srinathravichandran/Major-Project/Final Report/report images/Screenshot 2024-05-06 124802.png

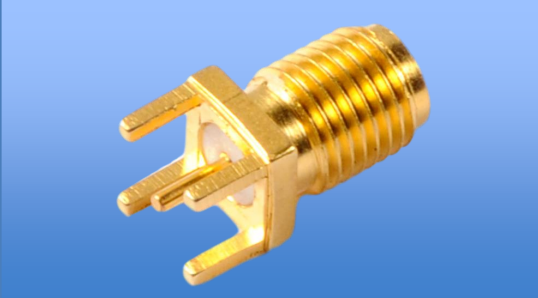
Final Report/report images/Screenshot 2024-05-06 124802.png
