srinathravichandran/Major-Project/Final Report/Radiation Pattern.png

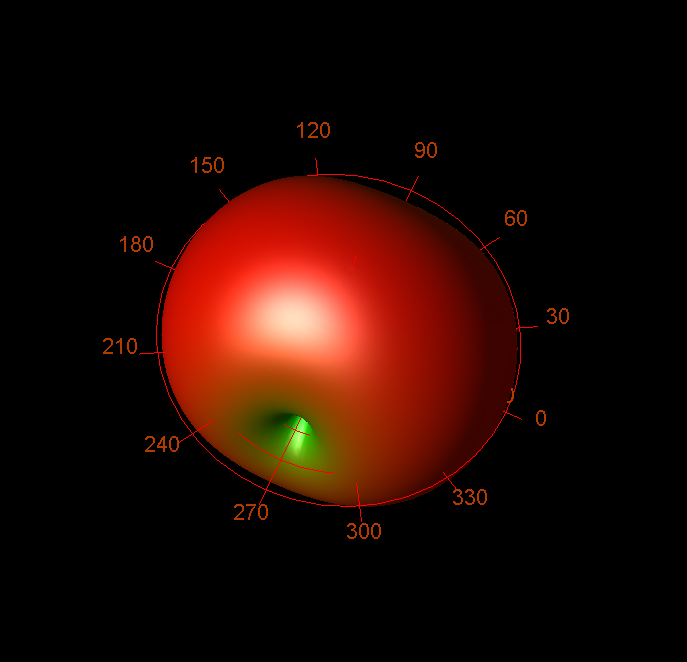
Final Report/Radiation Pattern.png
