srinathravichandran/Major-Project/Synopsis/Synopsis_124004308.docx

SYNOPSIS

Project Group No: 1

Register No: Name:

1. 124004308 Srinath.R

2. 124004361 Vijayarghavan.K.B

Project Title: Implementation of SDR-based Receiver using STM32 and nRF24L01

Name of the Guide: James A. Baskaradas / Associate Professor

Abstract

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

Specific Contribution

- On Omnidirectional Patch Antenna Designing, Fabricating & Testing it for a specific frequency of 2.4GHz
- On Interfacing the STM32 & nRF24L01 by employing embedded C on receiver side

Specific Learning

- Antenna Designing, Fabrication & Testing
- Embedded C

Technical Limitations & Ethical Challenges Faced

- Coding SPI Interface for nRF24L01
- Antenna Testing

Keywords: SPI Interface, nRF24L01, Patch Antenna, STM32, Dongle, Embedded C, Fabrication

Signature of the Student Signature of Guide

Date: 15th April 2024 1
