srinathravichandran/Major-Project/balun.png

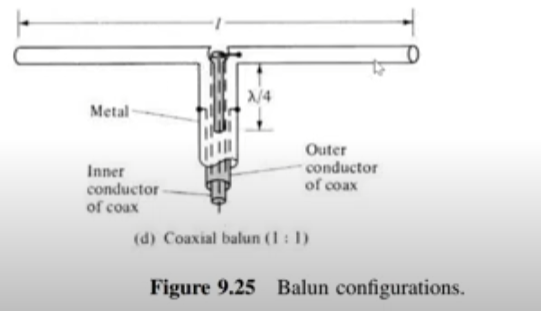
balun.png
