srinathravichandran/Major-Project/Final Report/Additional Graphs.png

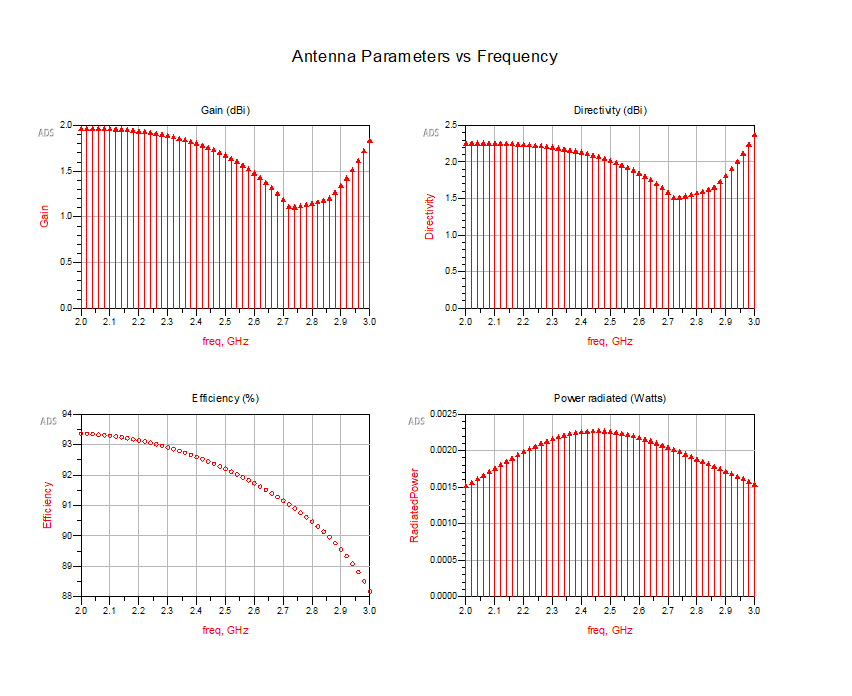
Final Report/Additional Graphs.png
