srinathravichandran/Major-Project/Final Report/Antenna Parameters.png

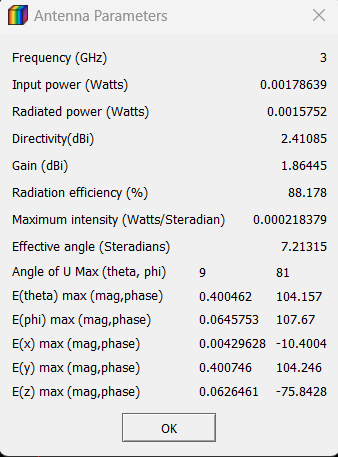
Final Report/Antenna Parameters.png
