srinathravichandran/Major-Project/Final Report/NEW/Patch_Antenna.png

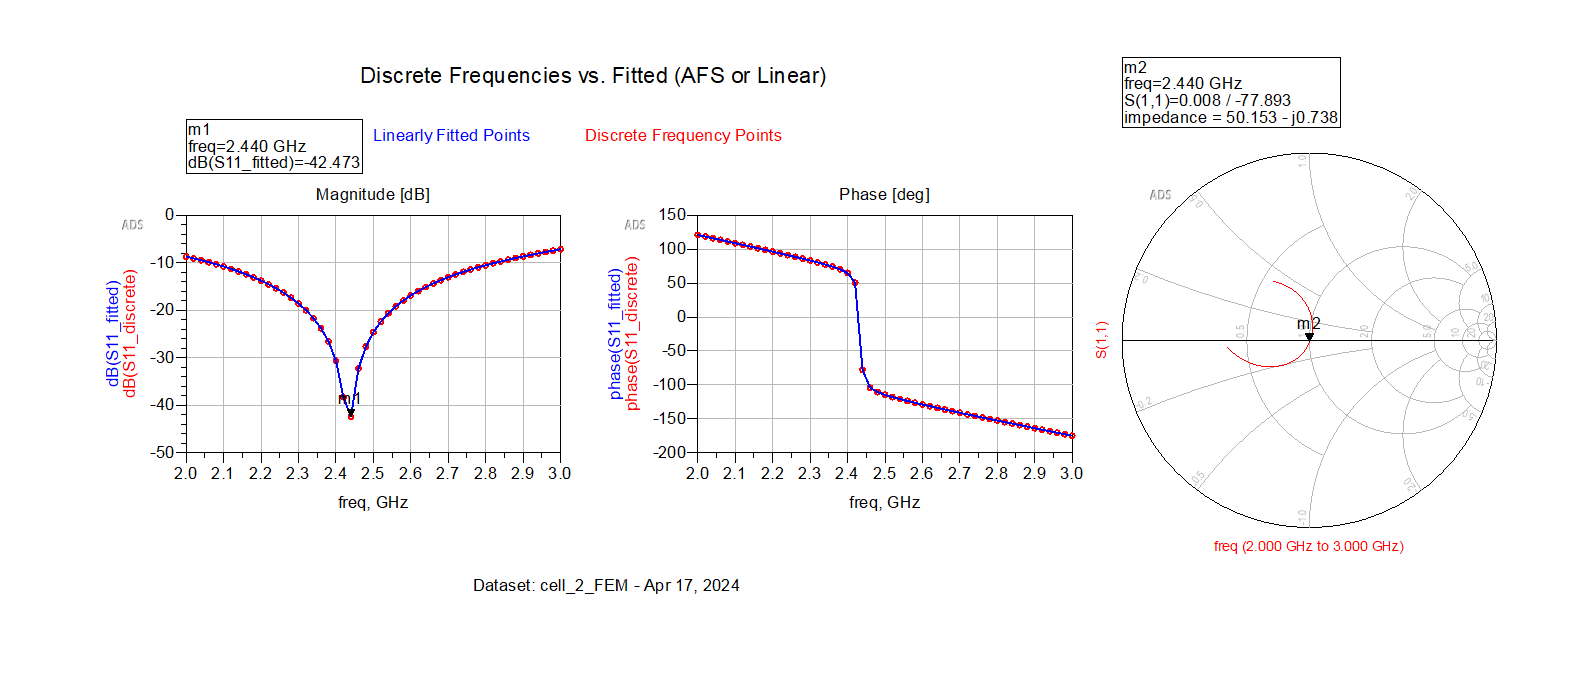
Final Report/NEW/Patch_Antenna.png
