srinathravichandran/Major-Project/Final Report/Patch Antenna.png

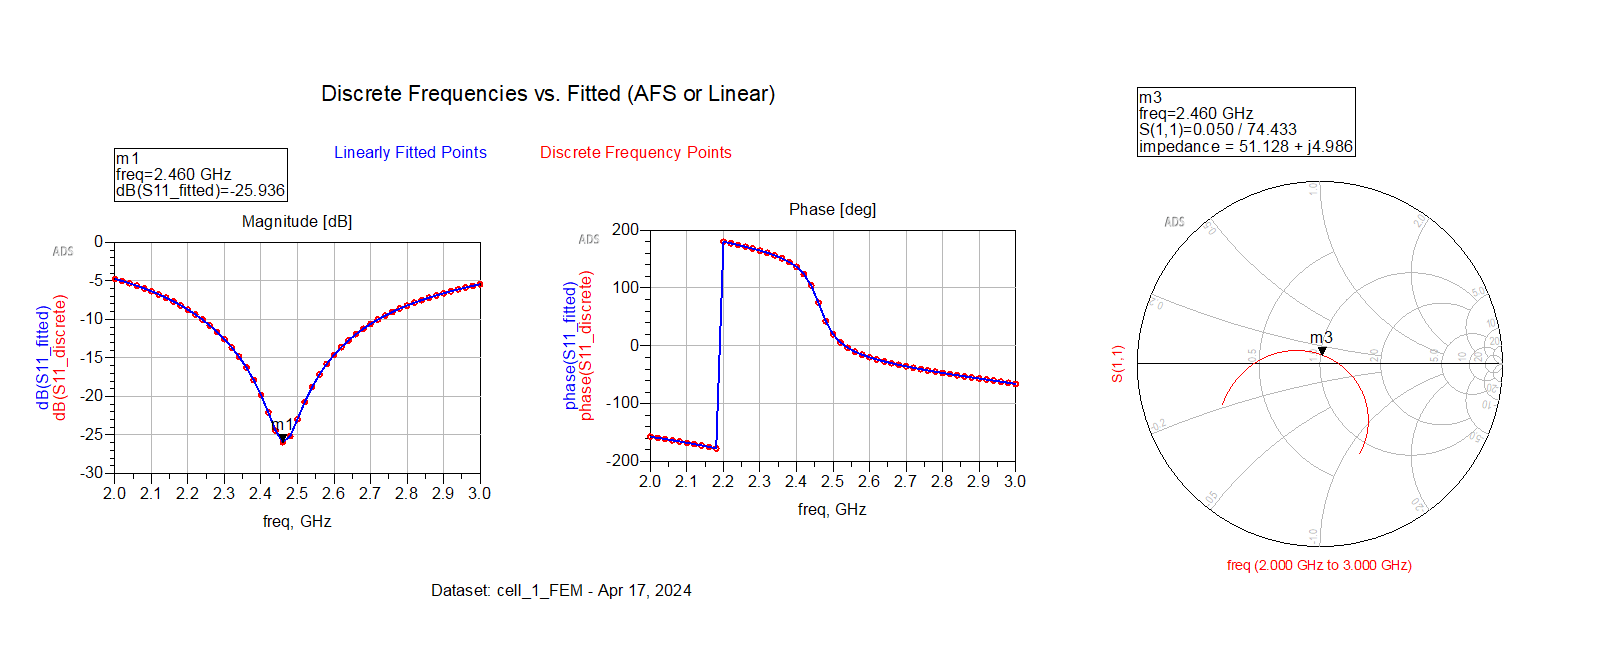
Final Report/Patch Antenna.png
