srinathravichandran/Major-Project/Final Report/report images/hardware and sdr.png

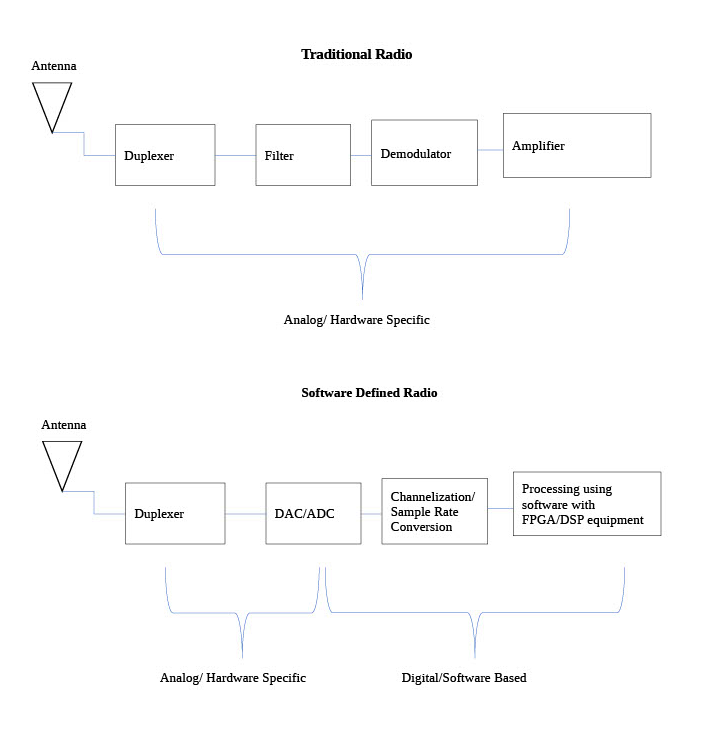
Final Report/report images/hardware and sdr.png
