srinathravichandran/Major-Project/frequency of C.D.A with Balun.png

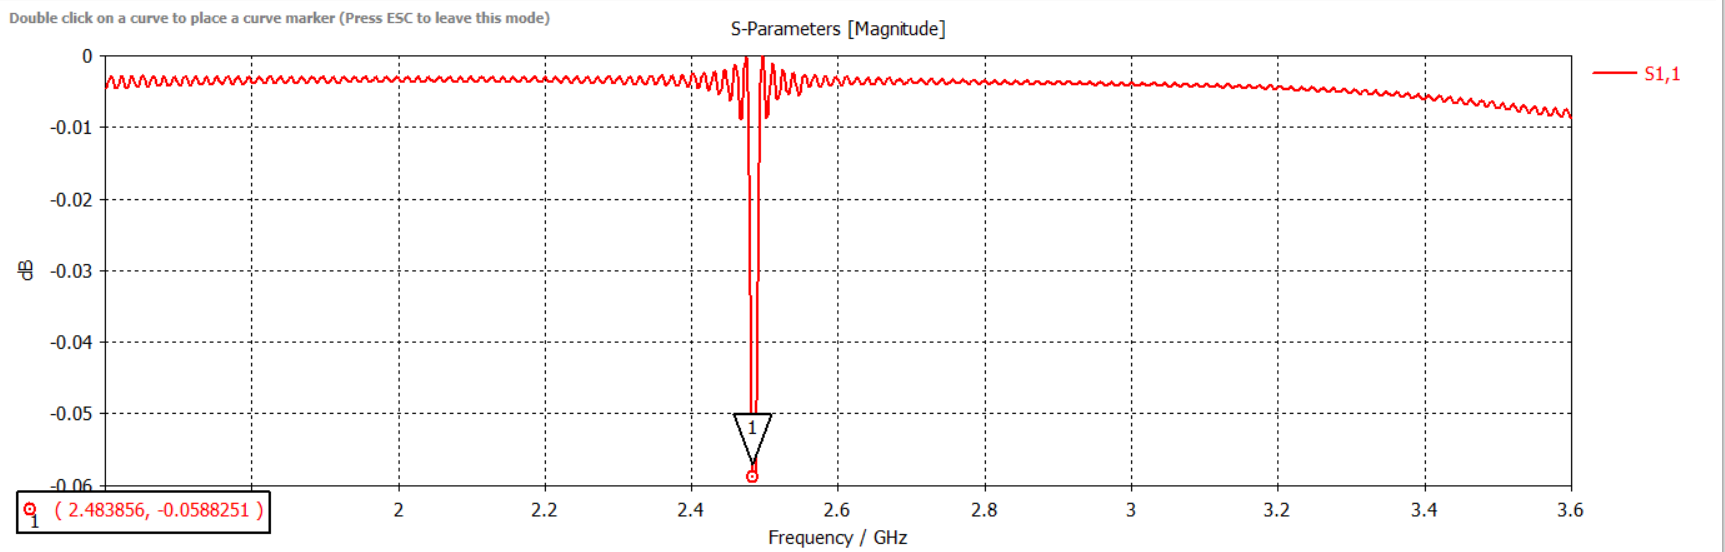
frequency of C.D.A with Balun.png
