srinathravichandran/Major-Project/patch antenna in ads.png

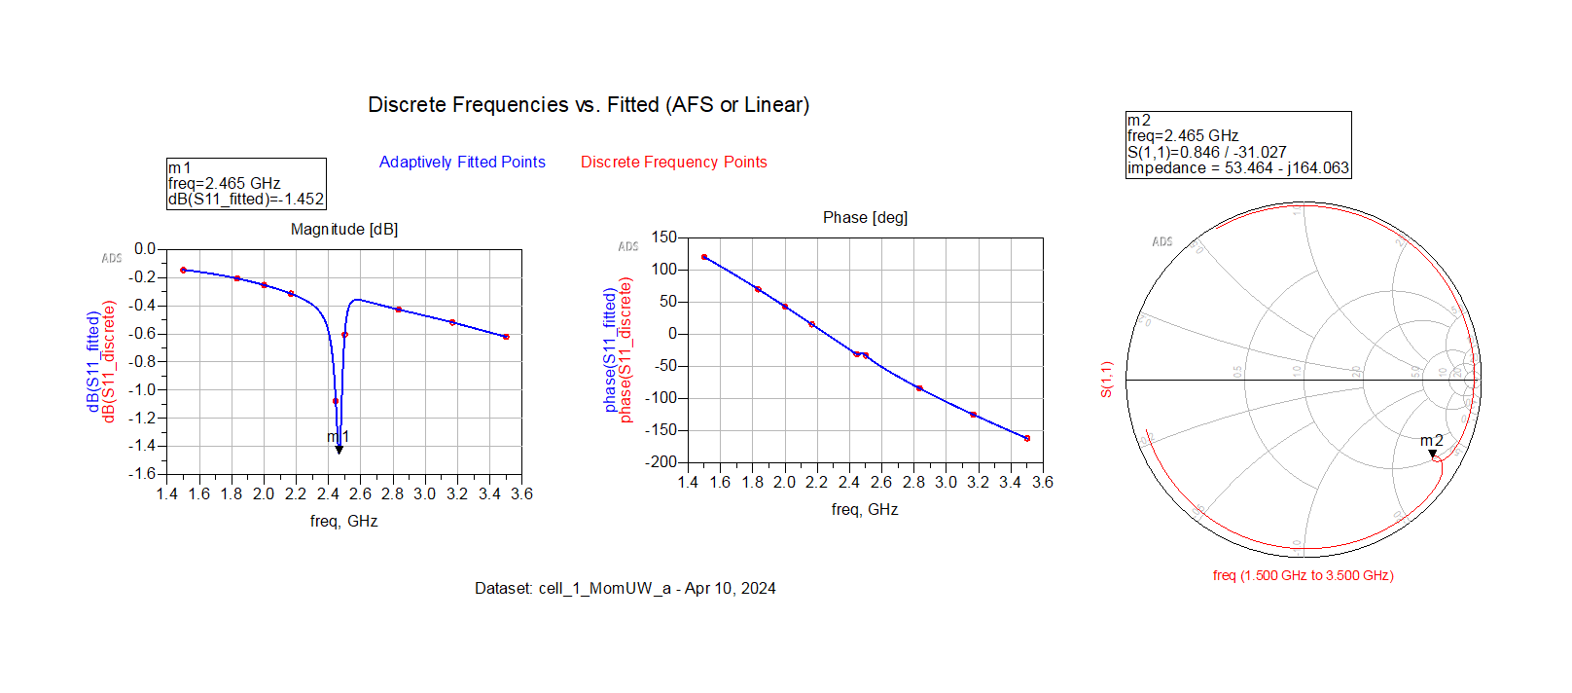
patch antenna in ads.png
