srinathravichandran/Major-Project/Screenshot 2024-04-25 120509.png

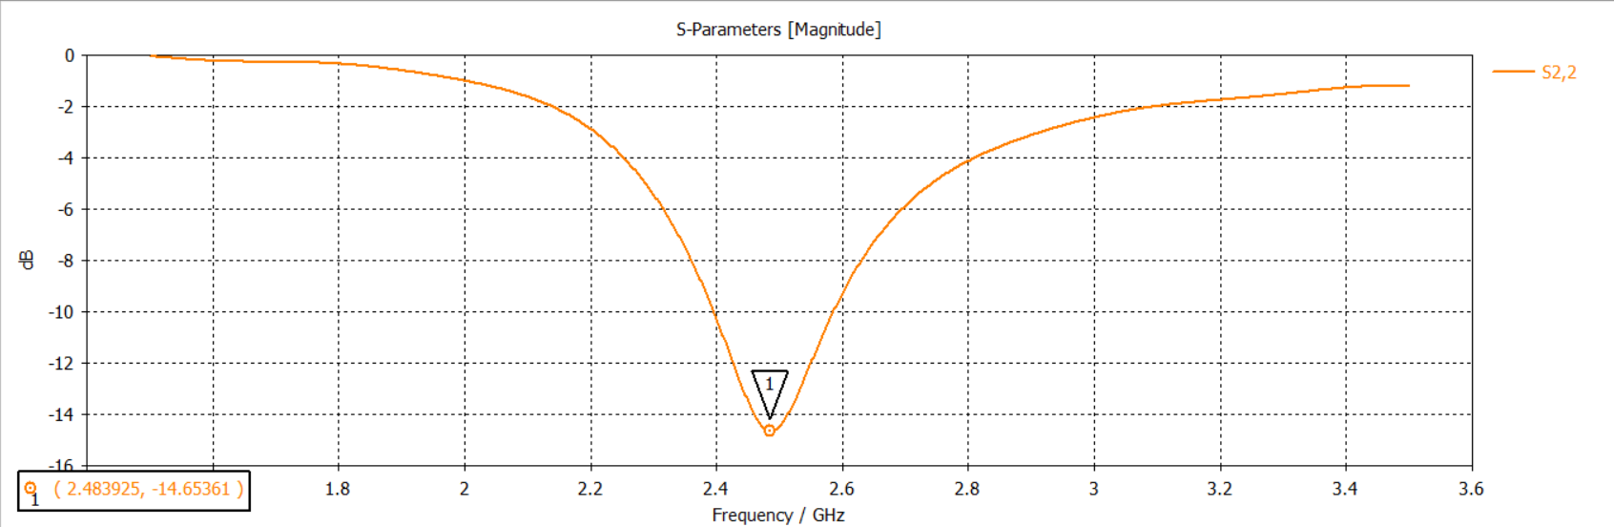
Screenshot 2024-04-25 120509.png
