srinathravichandran/Major-Project/Screenshot 2024-04-25 120854.png

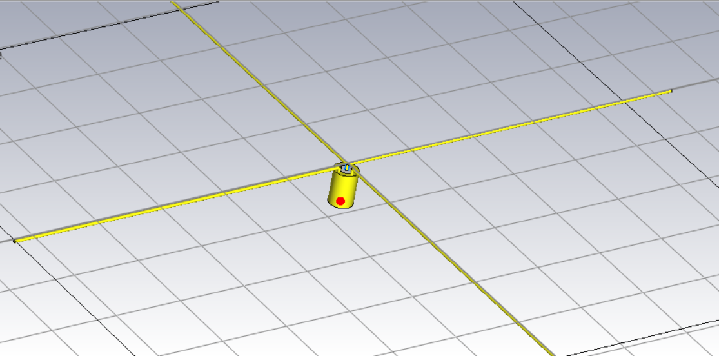
Screenshot 2024-04-25 120854.png
