srinathravichandran/Major-Project/Screenshot 2024-04-25 151421.png

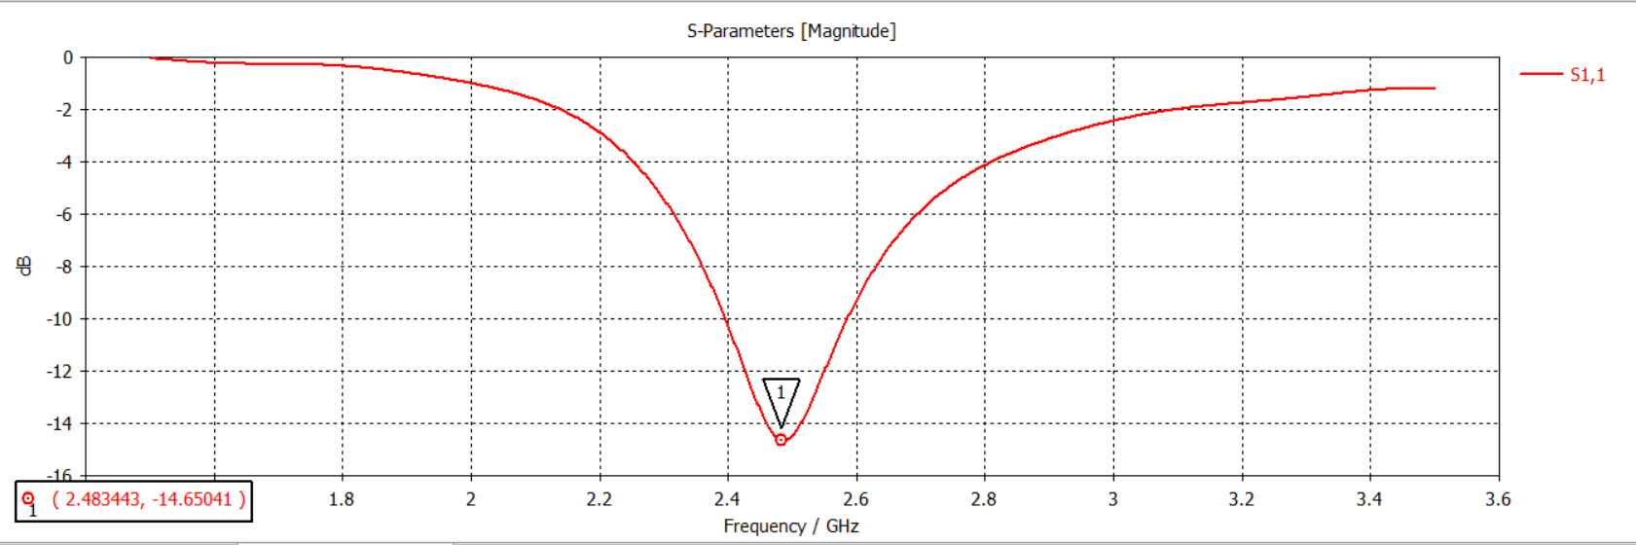
Screenshot 2024-04-25 151421.png
