srinathravichandran/Major-Project/trash/AD9854/AD9854_pin_diagram.jpg

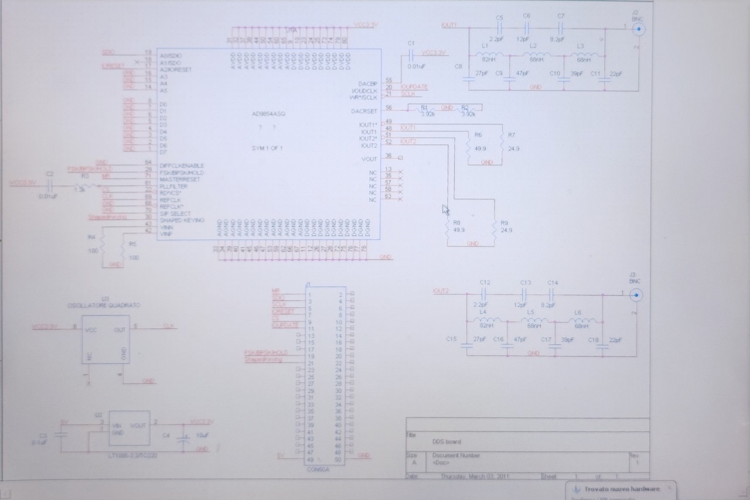
trash/AD9854/AD9854_pin_diagram.jpg
