srinathravichandran/Major-Project/trash/nRF to FPGA.png

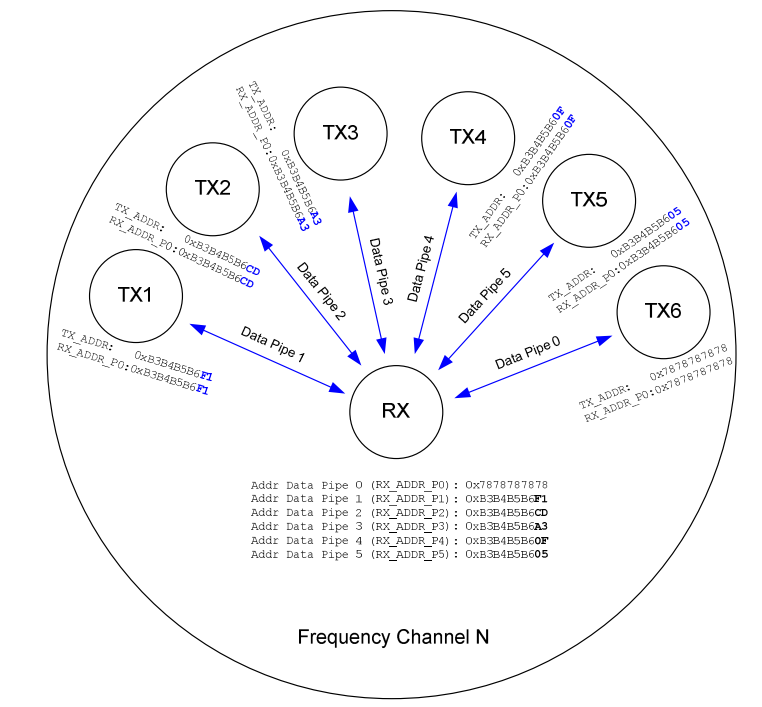
trash/nRF to FPGA.png
