srinathravichandran/Major-Project/trash/SPI.png

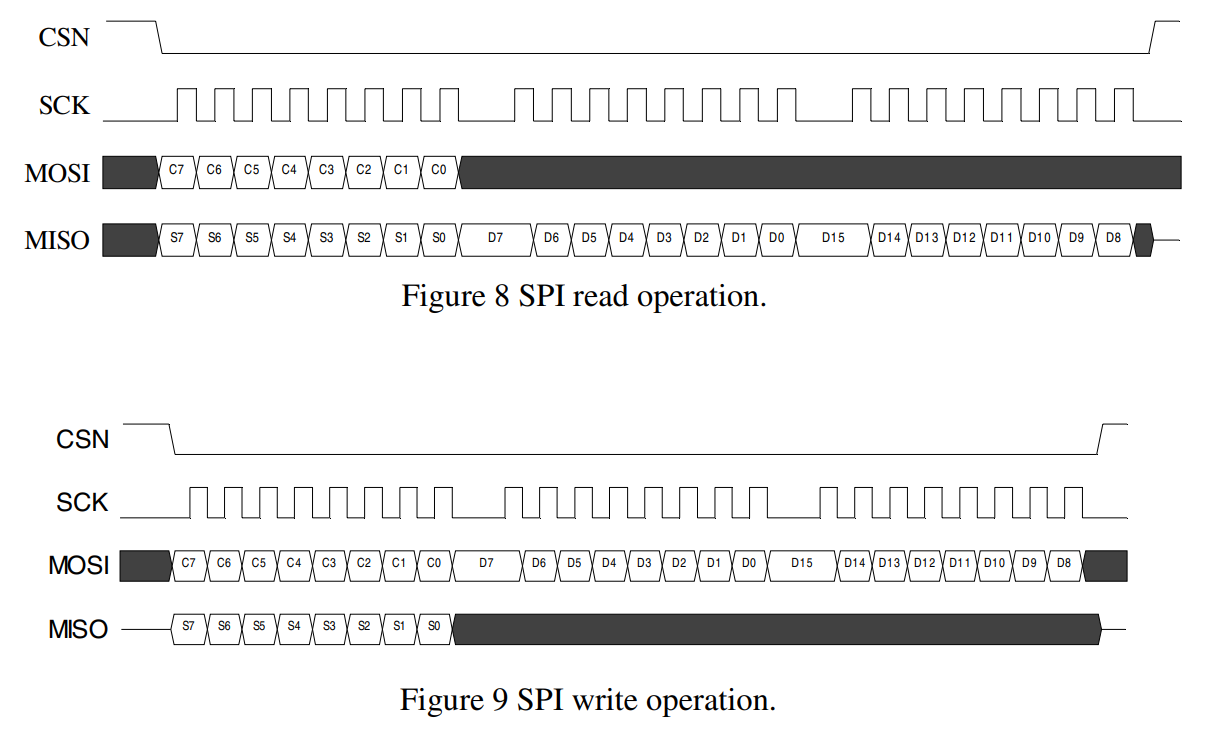
trash/SPI.png
