srinathravichandran/Major-Project/Trash/A_Horizontally_Polarized_Omnidirectional_Printed_Antenna_for_WLAN_Applications.pdf

IEEE TRANSACTIONS ON ANTENNAS AND PROPAGATION, VOL. 54, NO. 11, NOVEMBER 2006 | 3551

where the center pin is in contact with the hot electrode of the CPW
line and the four grounding pins are soldered to the ground-planes of this transmission line. The purpose of the small square slot at the center of the antenna (see Fig. 1 or Fig. 2) is help provide isolation between the hot electrode of the CPW transmission line and the surrounding ground-plane. In our original concept for the developed radiator, we were going to attempt to ‘edge’ feed the antenna from the center, however subsequently we were unable to source an interface small enough to accommodate the space required for the transition.

III. RESULTS

The predicted and measured return loss performance of the proposed small, uni-planar antenna is shown in Fig. 3. As can be seen from this plot, very good agreement between theory and experiment was achieved. The measured 10 dB return loss bandwidth for the radiator is 25 MHz compared to a predicted bandwidth of 35 MHz, however the minimum return loss for the measured case is better by almost 2 dB. The reasonable bandwidth, in excess of 5.5%, is due to the bandwidth of the slot primary radiating element, which inherently has more bandwidth than a patch antenna. The predicted and measured principal plane radiation patterns [XZ plane, =0 and YZ plane, = 90 where is defined in Fig. 1 and is the angle from the Z axis (out of the paper)] are shown in Fig. 4. Co-polar patterns are defined as radiation patterns with the linear polarization source antenna (a Yagi–Uda antenna) in the appropriate orientation and cross-polar patterns are taken with the source and antenna under test in orthogonal planes. The measurements were carried out at an outdoor antenna range. As can be seen from these results the patterns are in reasonable agreement, with higher cross-polarization levels, particularly towards endfire ( = 90), and scalping of the co-polar patterns in the measured patterns compared to the predicted results. These are characteristics that are typically observed for small antennas with truncated ground-planes. The measured gain was approximately 0 dBi, with an uncertainty of 2 dB. All cables used to make the measurement were covered with RF absorber to minimize their impact on the measured radiation patterns. The calculated efficiency of the antenna was approximately 75%.

IV. CONCLUSION

In this paper we have presented a new small, uni-planar printed antenna that has near omnidirectional radiation patterns. The antenna can be classified as a uni-planar version of a shorted spiral-like patch antenna, where in this case the primary radiator is a printed slot. The antenna is useful for wireless applications requiring thin, small radiators. Good agreement between the predicted and measured performance of the antenna has been achieved.

REFERENCES

[1] L. C. Godara, Handbook of Antennas in Wireless Communications. New York: CRC Press, 2002.
[2] W.-C. Liu, “Broadband dual-frequency meandered CPW-fed monopole antenna,” Electron. Lett., vol. 40, pp. 1319–1320, Oct. 2004.
[3] J.-Y. Chiou, J.-Y. Sze, and K.-L. Wong, “A broadband CPW-fed striploaded square slot antenna,” IEEE Trans. Antennas Propag., vol. 51, pp. 719–721, Apr. 2003.
[4] H. K. Kan and R. B. Waterhouse, “Small square dual-spiral printed antennas,” Electron. Lett., vol. 37, pp. 478–479, Apr. 2001.
[5] R. B. Waterhouse, “Small microstrip patch antenna,” Electron. Lett., vol. 31, pp. 604–605, Apr. 1995.
[6] N. K. Das and D. M. Pozar, “A generalized spectral domain Green’s function for multilayered dielectric substrates with applications to multilayered transmission lines,” IEEE Trans. Microw. Theory. Tech., vol. 35, pp. 326–335, Mar. 1987.

A Horizontally Polarized Omnidirectional Printed Antenna for WLAN Applications

C.-C. Lin, L.-C. Kuo, and H.-R. Chuang

Abstract—The design simulation, fabrication, and measurement of a 2.4-GHz horizontally polarized omnidirectional planar printed antenna for WLAN applications is presented. The antenna adopts the printed Alford-loop-type structure. The three-dimensional (3-D) EM simulator HFSS is used for design simulation. The designed antenna is fabricated on an FR-4 printed-circuit-board substrate. The measured input standing-wave-ratio (SWR) is less than three from 2.40 to 2.483 GHz. As desired, the horizontal-polarization H-plane pattern is quite omnidirectional and the E-plane pattern is also very close to that of an ideal dipole antenna. Also a comparison with the popular printed inverted-F antenna (PIFA) has been conducted, the measured H-plane pattern of the Alford-loop-structure antenna is better than that of the PIFA when the omnidirectional pattern is desired. Further more, the study of the antenna printed on a simulated PCMCIA card and that inserted inside a laptop PC are also conducted. The HFSS model of a laptop PC housing, consisting of the display, the screen, and the metallic box with the keyboard, is constructed. The effect of the laptop PC housing with different angle between the display and keyboard on the antenna is also investigated. It is found that there is about 15 dB attenuation of the gain pattern (horizontal-polarization field) in the opposite direction of the PCMCIA slot on the laptop PC. Hence, the effect of the large ground plane of the PCMCIA card and the attenuation effect of the laptop PC housing should be taken into consideration for the antenna design for WLAN applications. For the proposed antenna, in addition to be used alone for a horizontally polarized antenna, it can be also a part of a diversity antenna.

Index Terms—Alford loop, HFSS, horizontal polarization, laptop PC, omnidirectional, printed antenna, printed inverted-F antenna (PIFA), WLAN.

I. INTRODUCTION

Recently, with the rapid progress in the wireless communication technology, the demands of using the laptop and other portable computers with wireless modems as the terminals increase vastly in the wireless local area network (WLAN) applications. Given the antennas designed for the laptop PC, they can be simply classified into two categories: one is the built-in type and the other is integrated into an external interface card, such as the personal computer memory card international association (PCMCIA) card. Several kinds of the built-in antennas designed for the laptop PC have been introduced and studied [1]–[3]. It is noted that these built-in antennas can be integrated into the display panel or the chassis of the laptop PC. However in many current practical applications, as shown in Fig. 1, an external WLAN interface card (PCMCIA card) is normally plugged horizontally into a horizontal slot of the laptop PC. Also in the near future, the WLAN card may be built in with the laptop PC motherboard. In both situations, the printed antenna on the WLAN card is probably still situated in the horizontal plane and hence the antenna polarization may be dominant by the horizontally-polarized field. For example, a popularly used printed inverted-F antenna (PIFA) [4], in which it is reported that the dominant antenna pattern is basically in horizontal polarization but is not quite omnidirectional as desired in the H-plane.
In the urban or indoor wireless environment, after complicated multiple reflections or scatterings, the polarization of the propagating radio

Manuscript received December 21, 2004; revised June 8, 2006.
C.-C. Lin, L.-C. Kuo, and H.-R.Chaung are with the Institute of Computer and Communication Engineering, epartment of Electrical Engineering, National Cheng Kung University, Tainan, Taiwan, R.O.C. (e-mail: chuang_hr@ee.ncku. edu.tw).
Color versions of Figs. 1–13 are available online at http://ieeexplore.ieee.org. Digital Object Identifier 10.1109/TAP.2006.884307
Authorized licensed use limited to: SASTRA. Downloaded on March 20,2024 at 09:44:02 UTC from IEEE Xplore. Restrictions apply.

3552 | IEEE TRANSACTIONS ON ANTENNAS AND PROPAGATION, VOL. 54, NO. 11, NOVEMBER 2006

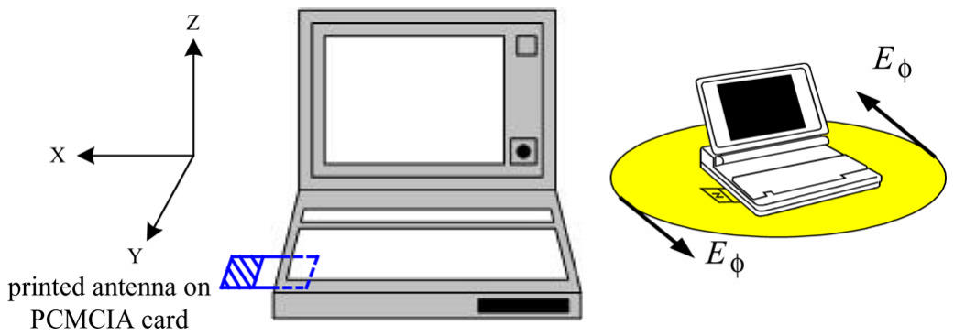
[picture p49: figure]

Fig. 1. (left) Illustration of the printed antenna on a PCMCIA card inserted inside a laptop PC for WLAN application and (right) a desired horizontally polarized omnidirectional pattern.

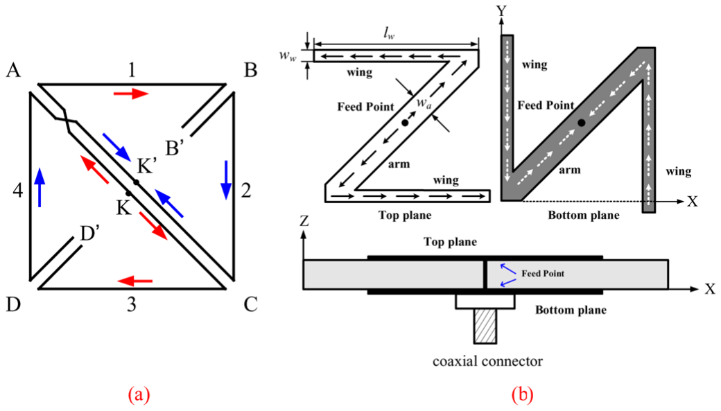
[picture p50: figure]

Fig. 2. Geometry of (a) original wire-structure Alford loop antenna presented in [6], and (b) a printed Alford-loop-structure antenna.

wave may change significantly. As reported in [4], [5], although many current wireless system are vertically polarized, it has been predicted that using horizontally polarized antenna at both the transmitter and receiver will result in 10 dB more power, as compared to the power received by using vertically polarized antennas at both end of the link. Hence, it seems that a horizontally polarized printed antenna with an omnidirectional pattern may be most suitable for the WLAN card application. Moreover, the effects of the laptop PC housing, including the location of the PCMCIA card, the tilted angle of the display screen, and the housing materials, will all affect the performances of the WLAN antenna and should be investigated in detail to obtain the final antenna patterns in the practical using condition.
In order to achieve the horizontally polarized radiation pattern, a loop antenna is a suitable choice. A small loop antenna with an uniform current distribution will have an omnidirectional pattern. However, a small loop antenna will have a very small radiation resistance and a high reactance. This will cause difficult impedance matching problem. A large loop antenna will have a reasonable radiation resistance. But the antenna current distribution along the loop becomes nonuniform and hence could not yield a desired omnidirectional pattern. To design a loop antenna with an omnidirectional pattern and an acceptable input impedance matching becomes a design challenge.
The wire-structure Alford loop antenna [Fig. 2(a)] to achieve an omnidirectional horizontally polarized waves was first reported in [6]. As shown in Fig. 2(a), the Alford loop antenna is fed at the terminal (K, K’) and due to the symmetric structure the current distribution on the conductors 1, 2, 3, and 4 will have the same magnitude and 180-degree phase difference. Also, since the conductors of BB’, DD’, and AC are very close to each other and the current flowing direction are opposite, the radiation of these current distribution will cancel by each other. Hence, the antenna currents on the Alford loop conductors 1, 2, 3, and 4 form a square-“loop” type current distribution, and a horizontally-polarized omnidirectional pattern can be achieved.
For the printed antenna purpose, a more convenient feeding mechanism and planar Alford-loop-structure antenna was adopted to design a 900-MHz planar printed omnidirectional horizontally polarized antenna [7]. In this paper, a 2.4-GHz printed WLAN antenna which adopts the printed structure of the Alford loop antenna is presented. Except designing an independent printed Alford loop antenna, the designed antenna printed on a simulated PCMCIA card and that inserted inside a laptop PC housing are also studied. The Ansoft HFSS three-dimension (3-D) EM simulator is utilized for antenna design simulation. The HFSS model of a laptop PC housing, consisting of the display, the screen, and the metallic box with the keyboard, is constructed. The effect of the laptop PC housing with different angle between the display and keyboard on the antenna is also investigated. For the proposed antenna, in addition to be used alone for a horizontally polarized antenna, it can be also a part of a diversity antenna.

II. ANTENNA DESIGN

As shown in Fig. 2, the printed Alford-loop-structure antenna consists of two Z-shaped strips printed on the top and bottom plane of the printedcircuit board (PCB). The bottom strip is arranged in such a manner that the “arm” is mapped to that of top strip through the PCB substrate. A coaxial connector is used to connect the central feed point of the top and bottom strips. The “wing” length of the Alford loop is of the order of a quarter of wavelength. Due to structure symmetry, the antenna current distribution on the two strips will have the same magnitude and 180-degree phase difference, as illustrated in Fig. 2(b). Since the PCB substrate thickness is very small, the radiation of the antenna current along the “arm” will cancel by each other. The antenna currents on the two “wings” of each “Z” strip establish a square-“loop”-type current distribution. This “loop”-type current distribution will radiate a horizontally polarized field and is expected to have an omnidirectional pattern.

A. Stand-Alone Antenna

In designing the printed Alford-loop-structure antenna, the dimensions of the Z-shaped strips including the length and width of the “arm” and the “wing” should be considered carefully for a good impedance matching. The length of the “wing” is approximately a quarter-wavelength. It is noted that from the study in [8], since the metal strip on the FR-4 substrate is without the ground plane, the metal strip does not belong to the microstrip line (which has a ground plane). Hence, unlike the wavelength associated with the effective dielectric constant used in the microstrip line, it is treated that the wavelength is approximated as that in a medium with a dielectric constant equivalent to the average of that in free space and the substrate ("r), which is (1 + "r)=2. Hence the length of the “wing” (quarter-wavelength), lw, is expressed as

lw =0:25 -

[e]=0:25 -

[0= (1 + "r)=2]: | (1)

At 2.45 GHz lw is approximately equal to 18 mm for FR-4 substrate ("r =4:7). However, the accurate length and width has to be finetuned by HFSS 3-D EM simulation. After the HFSS fine-tuning, lw is set to be 17.8 mm. Table I shows the dimensions of a designed 2.4-GHz printed Alford-Loop-structure antenna on an FR-4 substrate.
Fig. 3 shows the simulated surface current distributions of a designed 2.4-GHz Alford-loop-structure antenna. The symmetrical current distribution on the top and bottom strips is observed. Fig. 4 shows the photograph of a realized printed Alford-loop-structure antenna on an FR-4 PCB substrate and the measured input standing-wave-ratio (SWR). It can be observed that the measured input SWR is less than 3 from 2.40 to 2.483 GHz. Fig. 5 shows the measured antenna patterns of the horizontal- and vertical-polarization field in the H-plane (xy-plane, = 90) and E-plane (xz-plane, =0). As expected, instead of the vertical-polarization field, the horizontal-polarization H-plane pattern is quite omnidirectional and the E-plane pattern is also very close to that of an ideal dipole antenna.
Comparison With the Printed Inverted-F Antenna (PIFA): For comparison with the PIFA [9]–[12], a 2.4-GHz PIFA is realized on an FR-4

IEEE TRANSACTIONS ON ANTENNAS AND PROPAGATION, VOL. 54, NO. 11, NOVEMBER 2006 | 3553

TABLE I
DIMENSIONS OF A PLANAR PRINTED ALFORD-LOOP-STRUCTURE ANTENNA ON AN FR-4 SUBSTRATE

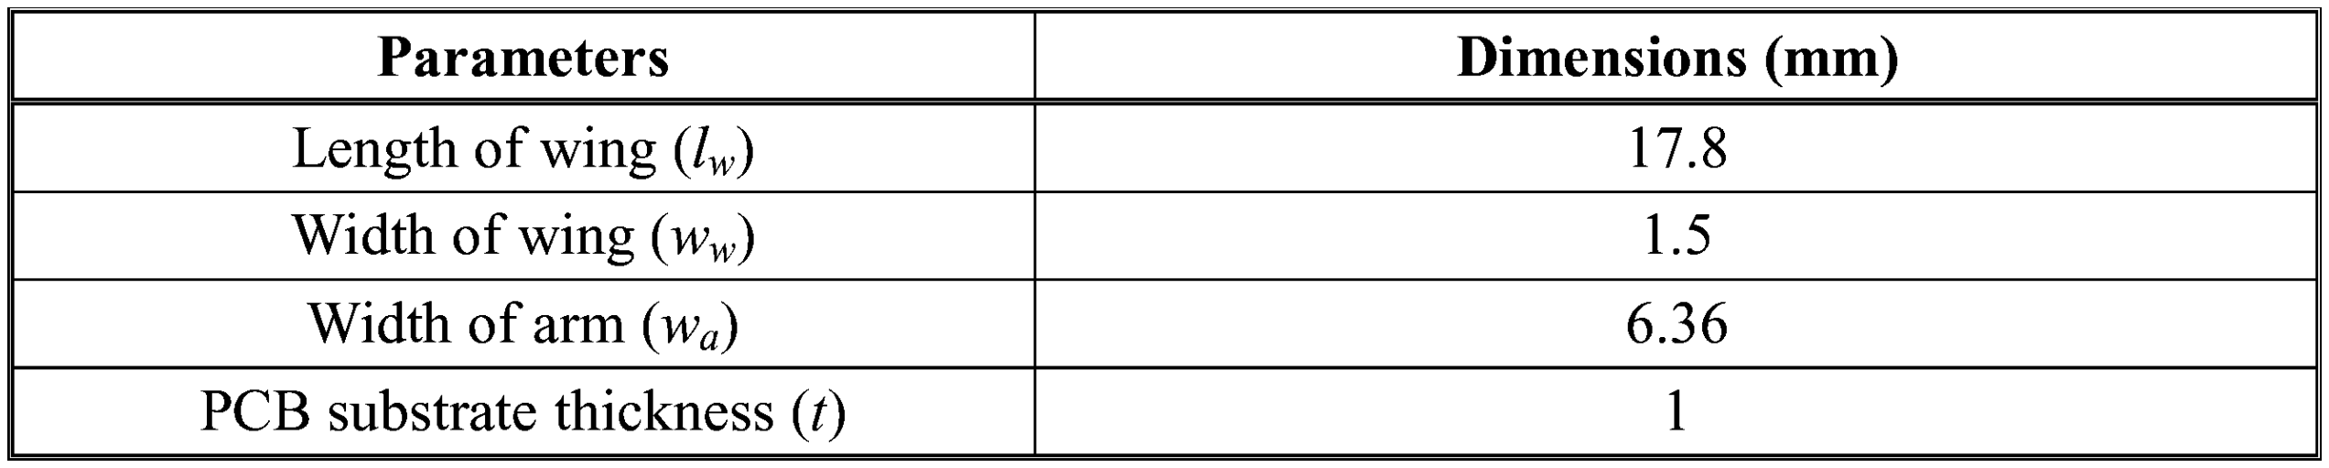
[picture p51: figure]
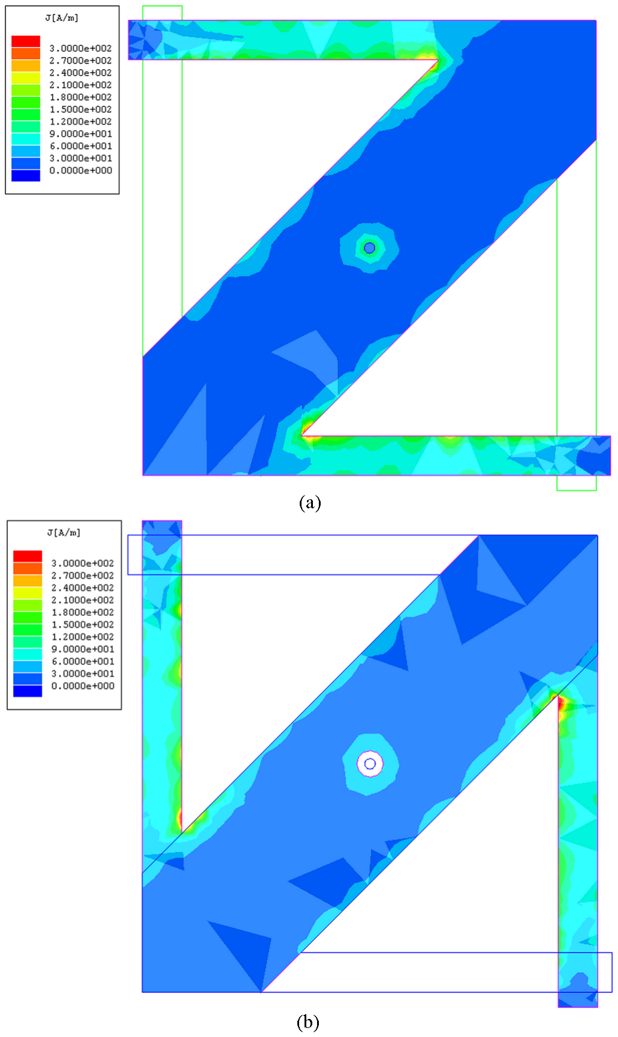
[picture p52: figure]

Fig. 3. The simulated current distributions of the printed Alford-loop-structure antenna. (a) On the top metal. (b) On the bottom metal.

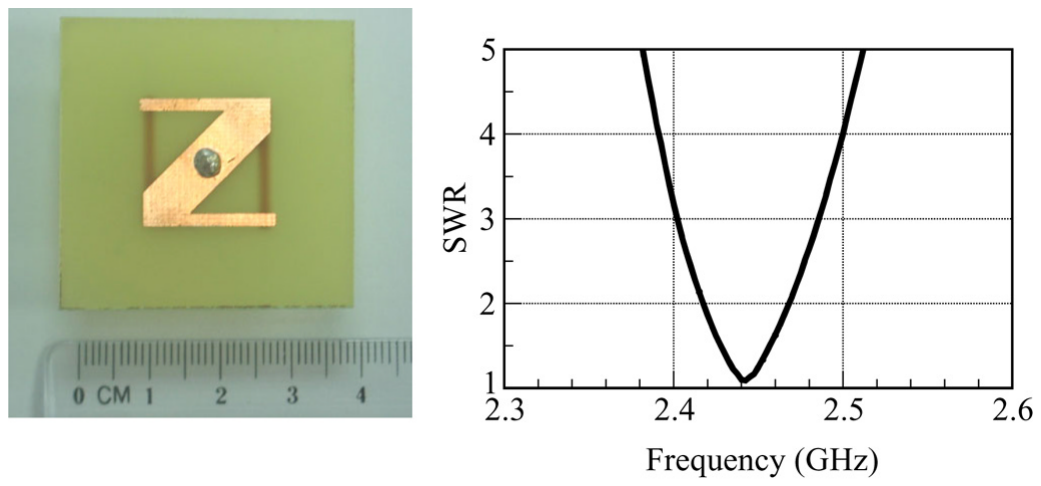
[picture p53: figure]

Fig. 4. Photograph of a realized printed Alford-loop-structure antenna on an FR-4 PCB substrate and the measured input SWR.

substrate of which the dimension is the same as that of the Alford-loop-structure antenna. As shown in Fig. 6(a) and (b), the PIFA is fed with

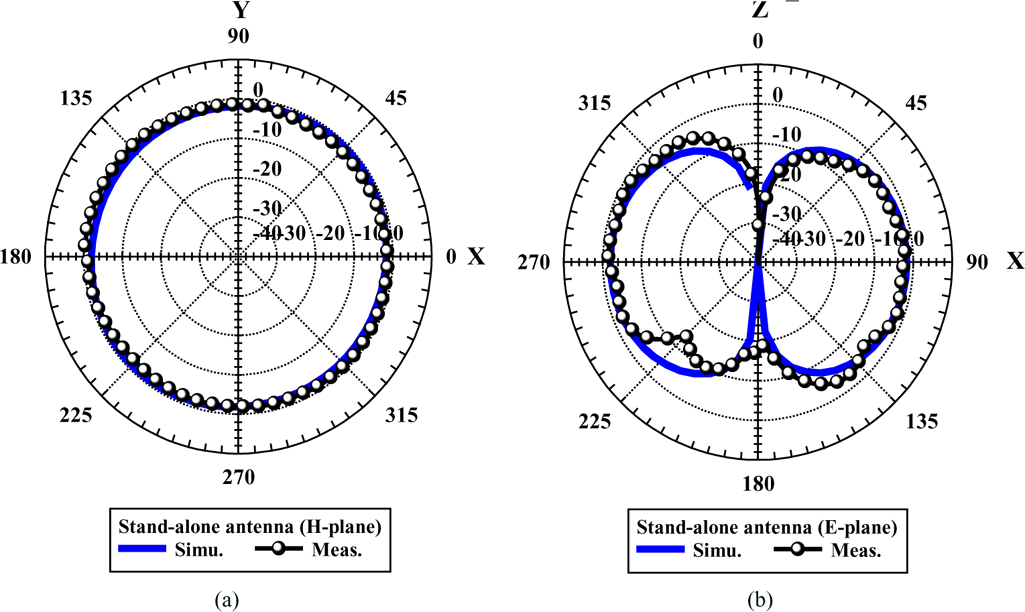
[picture p54: figure]

Fig. 5. Simulated and measured radiation patterns of the horizontal-polarization field of a 2.4-GHz printed Alford-loop-structure antenna. (a) In the H-plane.
(b) In the E-plane.

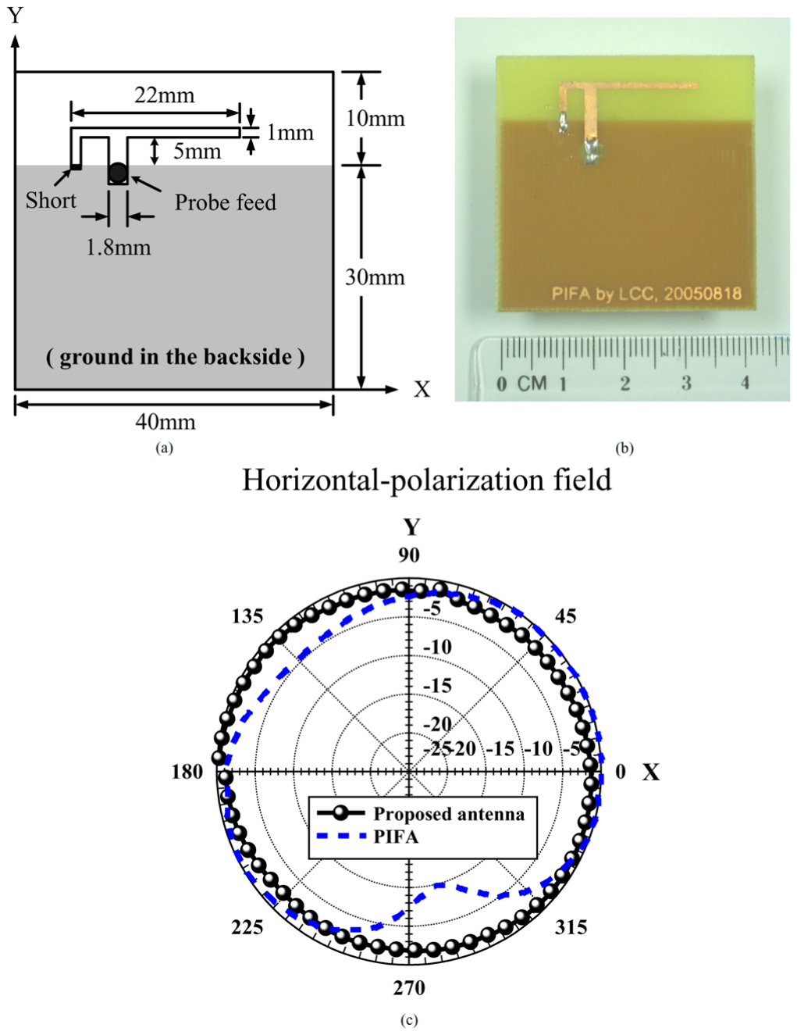
[picture p55: figure]

Fig. 6. (a) Schematic of a 2.4-GHz PIFA, (b) photograph of a realized 2.4-GHz PIFA on an FR-4 substrate, (c) comparisons of the measured H-plane patterns.

the coaxial probe and the dimension of ground plane in the backside is 40 -

30 mm². As shown in Fig. 6(c), the H-plane pattern of the Alford-loop-structure antenna is better than that of the PIFA when the omnidirectional pattern is desired.

3554 | IEEE TRANSACTIONS ON ANTENNAS AND PROPAGATION, VOL. 54, NO. 11, NOVEMBER 2006

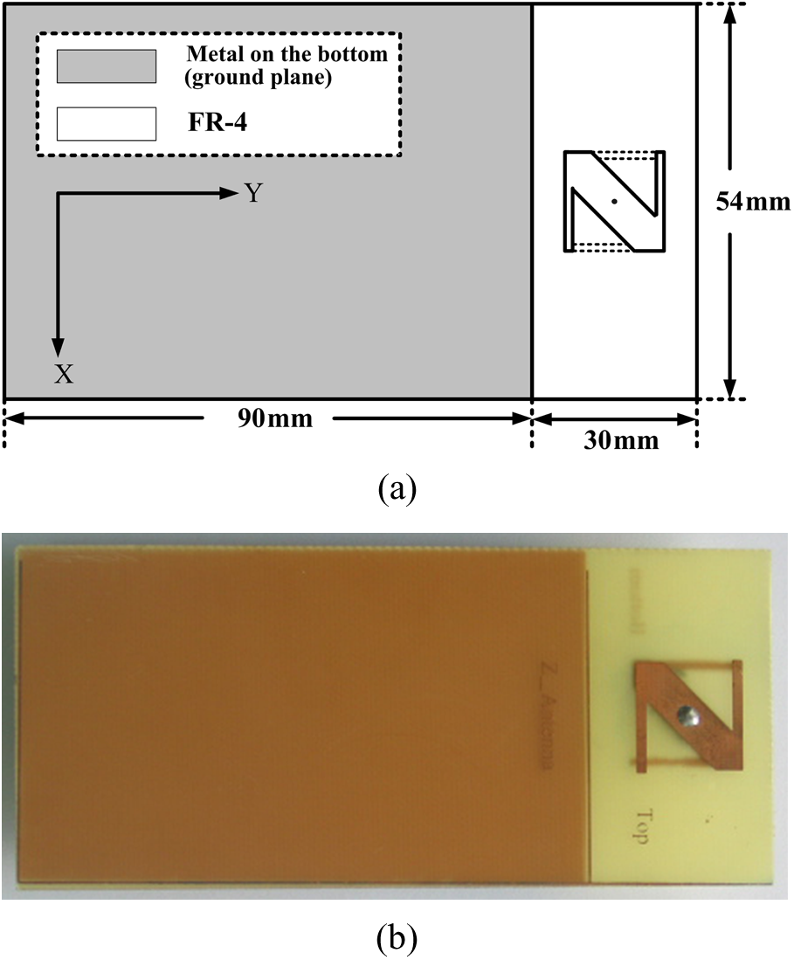
[picture p56: figure]

Fig. 7. (a) Geometry and (b) photograph of a fabricated Alford-loop-structure antenna on a simulated PCMCIA card.

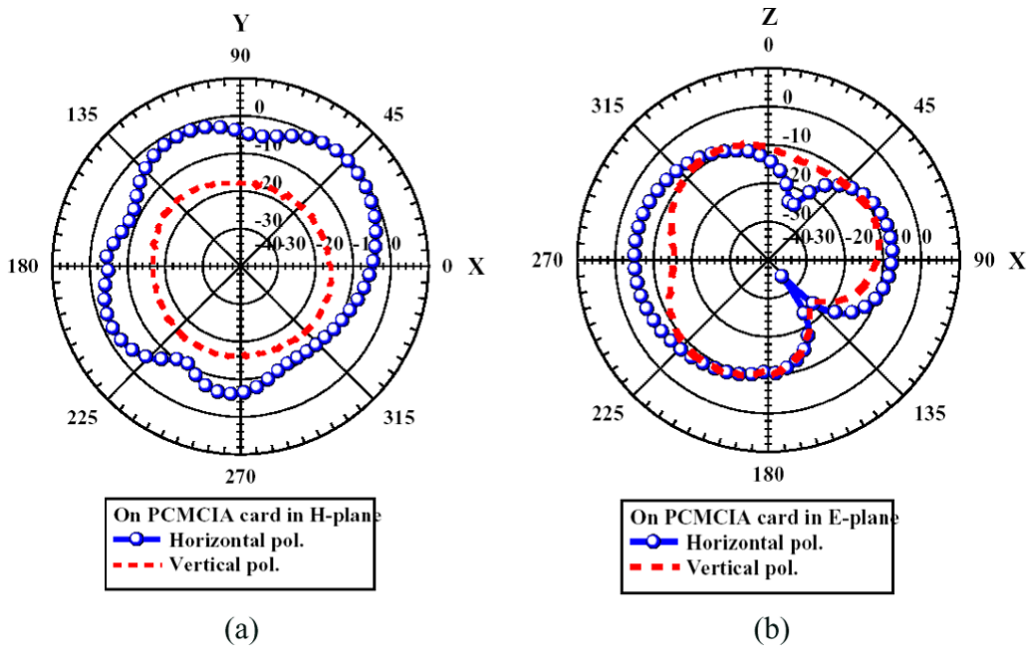
[picture p57: figure]

Fig. 8. Measured radiation patterns of the horizontal-polarization field for the Alford-loop-structure antenna printed on a simulated PCMCIA card in:
(a) H-plane. (b) E-plane.
B. Antenna Printed on a Simulated PCMCIA Card

Fig. 7 shows the geometry and the photograph of an Alford-loop-structure-type antenna printed on an FR-4 PCB board (120 -

54 mm²)
which has the same dimension as a practical WLAN PCMCIA card. The metallic plane (90 -

54 mm²) on the bottom is to simulate the ground plane of the PCMCIA card. Fig. 8 shows the measured radiation patterns of the horizontal-polarization field. Due to the large ground plane effect, the pattern is distorted from the omnidirectional pattern and the measured average antenna gain in the H-plane is 5:3 dBi. Here, the H-plane average gain, Gavg, is the average of gain values of the associated N points in the H-plane which can be formulated as

Gavg = 1
N

N

i=1

Gp | =
2 ;i | i = i -

2
N | (2)

where Gp is the value of the antenna gain at each specified position. In this paper, we measure 180 points for the antenna gain (pattern) in the

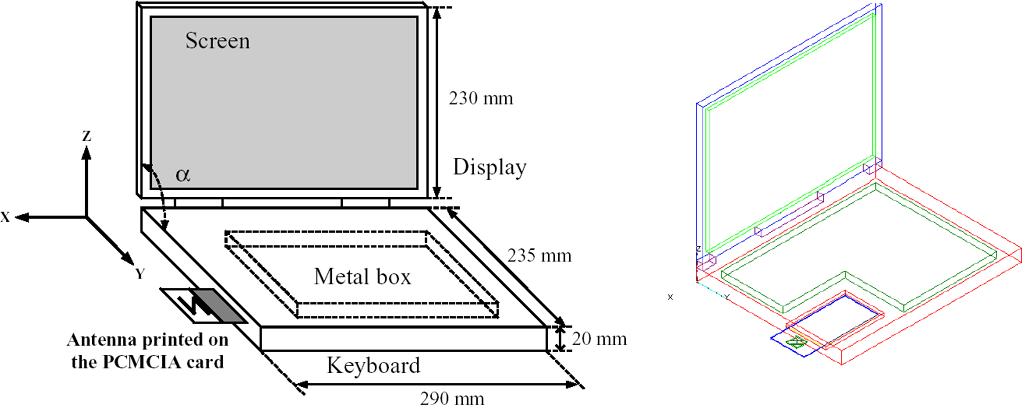
[picture p58: figure]

Fig. 9. The geometry and dimensions of a simulated laptop PC housing model (left) and the HFSS simulation schematics (right).

H-plane (2-degree per point). The average gain is the average of gain values of the associated 180 points.
As shown in Table III, it is noted that the average gain of the vertical-polarization field is about 11 dB less than that of the horizontal-polarization field. The effects due to the large ground plane of the PCMCIA card, such as attenuations of the antenna patterns, should be taken into considerations for the antenna design in WLAN card.
C. Antenna Printed on Simulated PCMCIA Card Inserted to a Laptop PC

To simulate the effects of the laptop PC housing on the printed Alford-loop-structure antenna on a PCMCIA card, a laptop PC model, which consists of the display, the screen (inside the display), and the keyboard (including a metallic box inside), is constructed as shown in Fig. 9 (left). Table II lists the details of the materials: the display is polyethylene ("r =2:25) covered by a perfect electrical conductor (PEC), the screen is glass ("r =5:5; = 1012 S/m), and the keyboard is polyethylene with a metallic box inside. The angle between the display and keyboard is defined as . The effect of the laptop PC housing with different angle between the display and keyboard on the antenna is also investigated. The HFSS simulation schematic is also shown in the figure (right).
Fig. 10 shows the HFSS simulated E-field distribution around the laptop PC housing. Fig. 11 presents the HFSS simulated antenna patterns of the horizontal-polarization field in the H-plane with the angles of = 90; 120; and 135 that are usually used in practical cases. It is found that the differences are not obvious. In the following cases, the angle of will be set as 90-degree.
Fig. 12 shows a photograph of the pattern measurement of the antenna (printed on a PCMCIA card) inserted inside a laptop PC in an anechoic chamber. Fig. 13 presents the measured antenna patterns in the H-plane for the three aforementioned cases: the stand-alone Alford-loop-structure antenna, the antenna printed on a simulated PCMCIA card, and that inserted inside the laptop PC. For the case of the antenna printed on the PCMCIA card inside a laptop PC, it can be observed that there is about more than 15 dB attenuation of the gain pattern in the opposite direction of the PCMCIA slot of a laptop PC. The measured average H-plane antenna gain of the E field is about 8:0 dBi. More detailed comparisons of the measured antenna gains are listed in Table III. It is noted that the maximum E-field (7:0 dBi) of the antenna on the PCMCIA card inserted inside the laptop is higher than that (15:3 dBi) of the antenna on the PCMCIA card (in free space). It can be explained that, for a horizontally-polarized antenna, E is a cross-polarized field and hence the laptop housing effect could be possible to induce a high level of cross-polarization when the PCMCIA card (with the printed antenna) inserted inside it. This information will be useful for analyzing characteristics of antennas used for WLAN applications. Furthermore, how to reduce the attenuation effect of the laptop PC housing and maintain the desired performance of antennas is needed for more advanced study.

IEEE TRANSACTIONS ON ANTENNAS AND PROPAGATION, VOL. 54, NO. 11, NOVEMBER 2006 | 3555

TABLE II
LAPTOP HOUSING COMPONENTS AND MATERIALS FOR HFSS SIMULATION

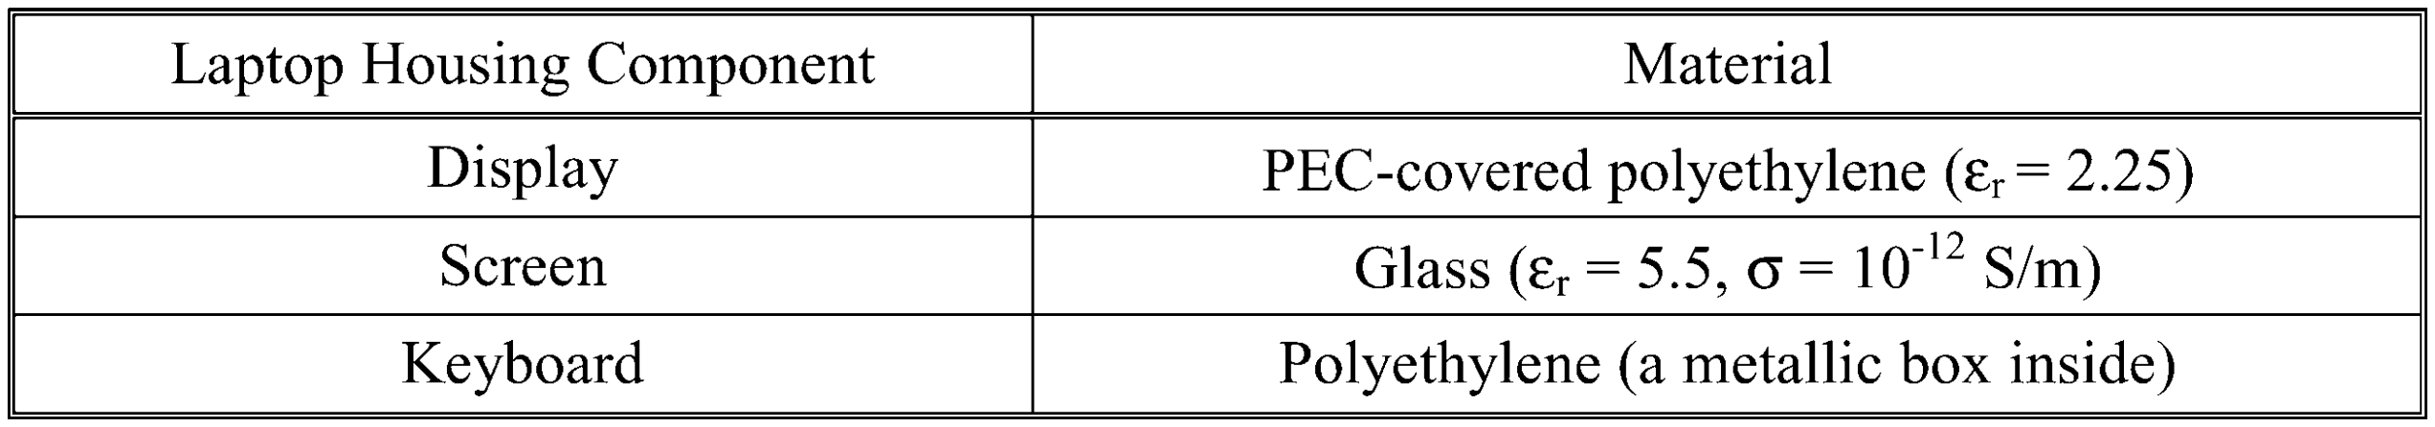
[picture p59: figure]

TABLE III
COMPARISONS OF MEASURED ANTENNA GAINS IN THE H-PLANE

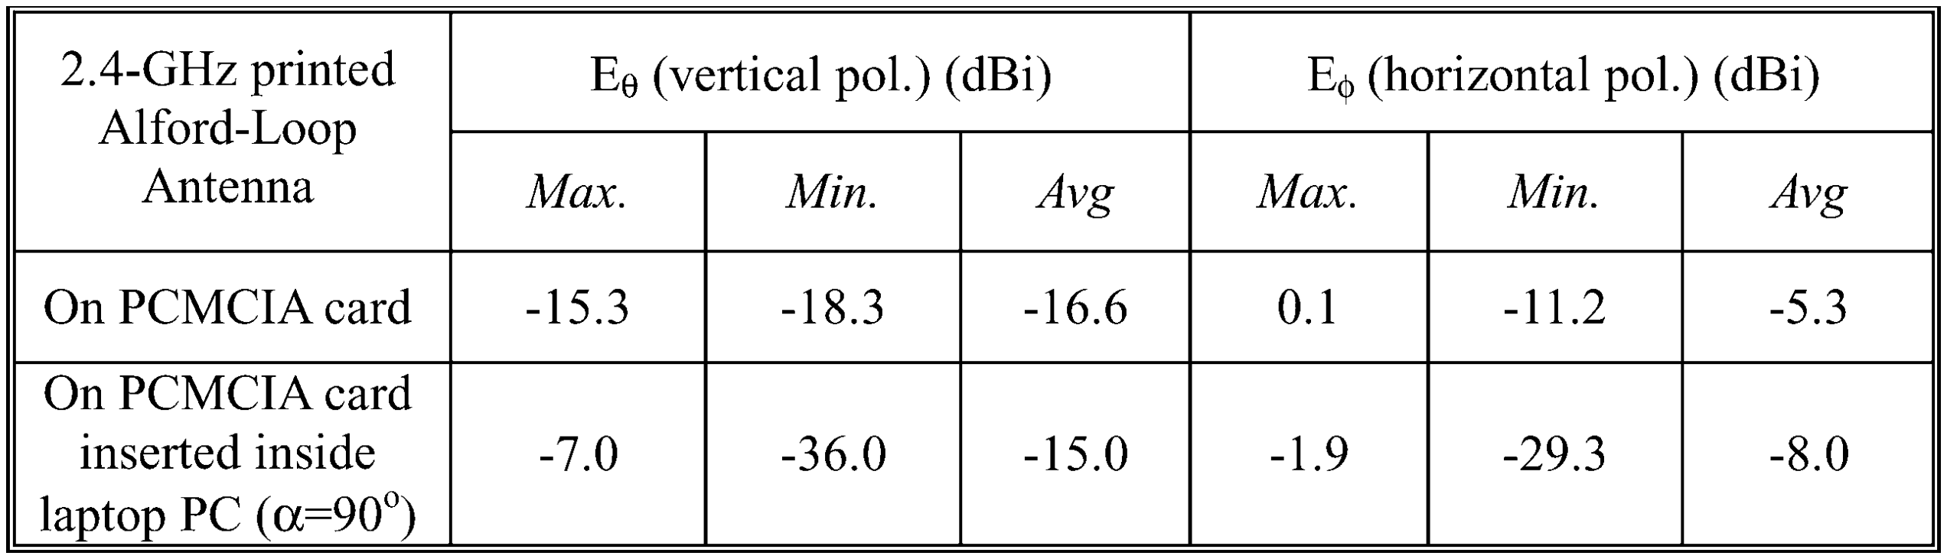
[picture p60: figure]
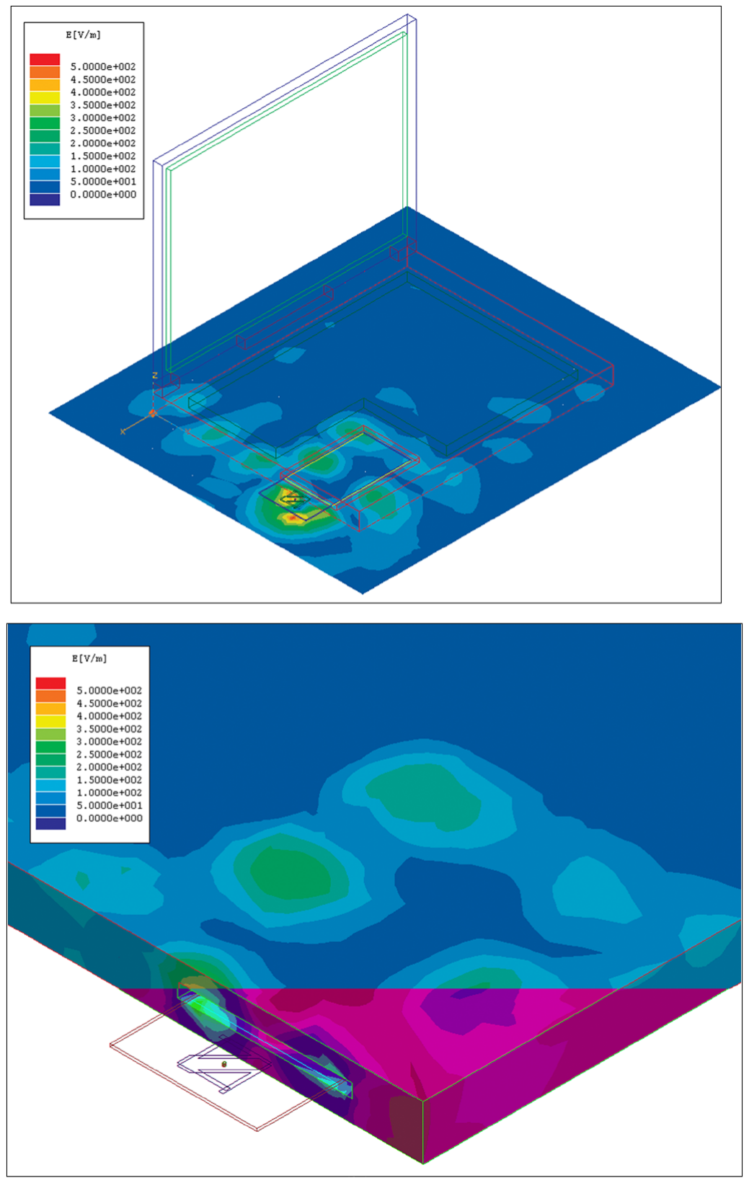
[picture p61: figure]

Fig. 10. HFSS simulated E-field distribution around the laptop PC housing.

III. CONCLUSION

A 2.4-GHz omnidirectional horizontally polarized planar-printed antenna which adopts the Alford-loop-type structure has been designed, fabricated on an FR-4 PCB board. The measured input SWR of the antenna is less than three from 2.40 to 2.483 GHz. The horizontal-polarization H-plane pattern is quite omnidirectional and the

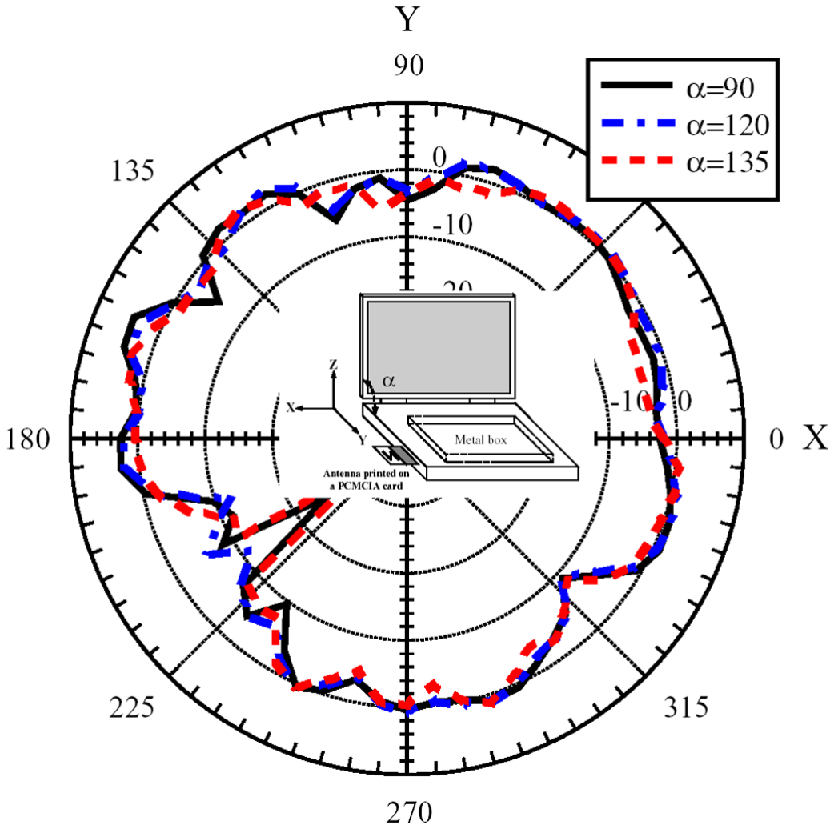
[picture p62: figure]

Fig. 11. Simulated antenna patterns of the horizontal-polarization field in the H-plane for the Alford-loop-structure antenna printed on a simulated PCMCIA card inside the laptop PC with angles of = 90 , 120 , and 135 .

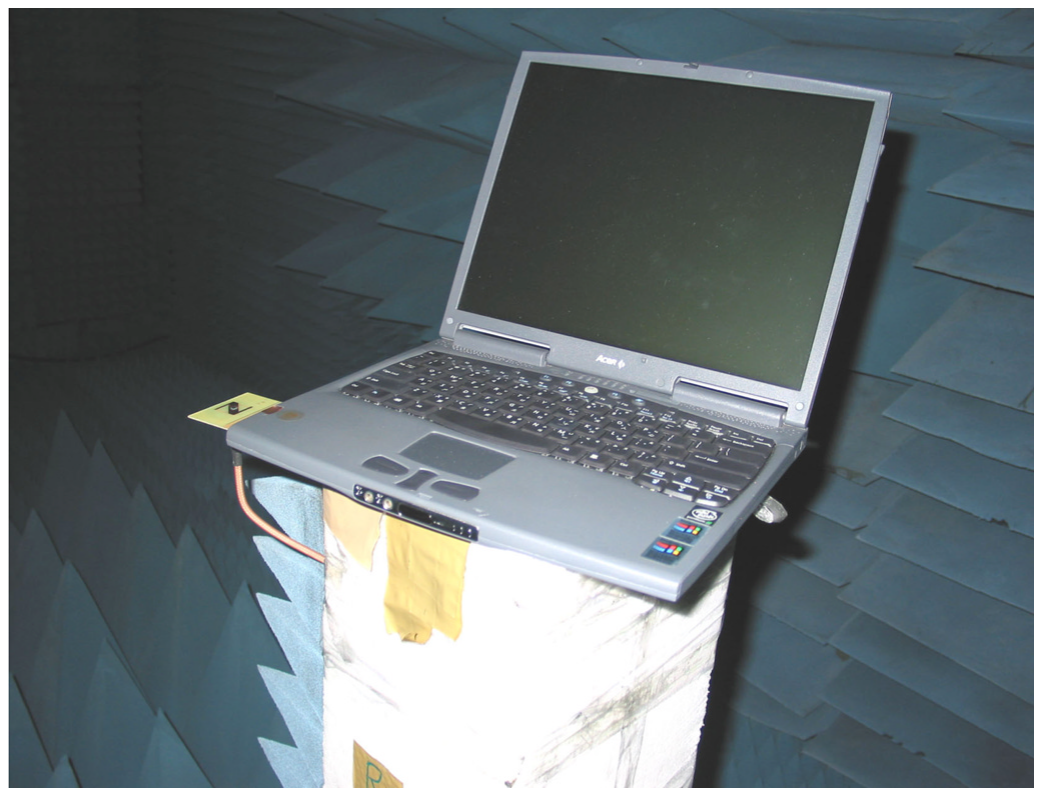
[picture p63: figure]

Fig. 12. Photograph of the pattern measurement of the antenna (printed on a PCMCIA card) inserted inside a laptop PC in an anechoic chamber.

3556 | IEEE TRANSACTIONS ON ANTENNAS AND PROPAGATION, VOL. 54, NO. 11, NOVEMBER 2006

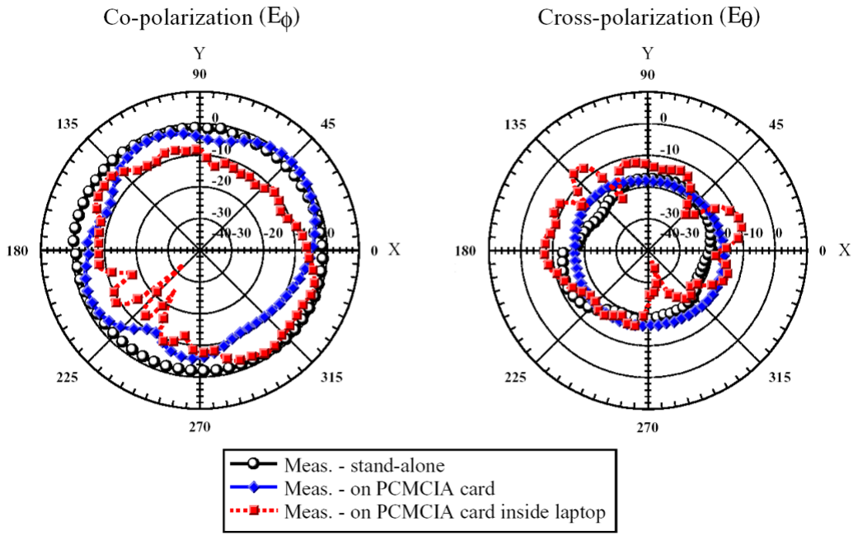
[picture p64: figure]

Fig. 13. Measured antenna patterns in the H-plane for the three cases: a stand-alone Alford-loop-structure antenna, the antenna printed on a simulated PCMCIA card, and that inserted inside a laptop PC.

E-plane pattern is also very close to that of an ideal dipole antenna. For comparison with the PIFA, a 2.4-GHz PIFA is realized on an FR-4 substrate. The measured H-plane pattern of the Alford-loop-structure antenna is better than that of the PIFA when the omnidirectional pattern is desired. Further more, study of the antenna printed on a simulated PCMCIA card and that inserted inside a laptop PC are also conducted. The antenna printed on a simulated PCMCIA card has an average antenna gain (horizontal-polarization field) of 5:3 dBi. The HFSS model of a laptop PC housing, consisting of the display, the screen, and the metallic box with the keyboard, is constructed to investigate the effects of the antenna printed on a PCMCIA card and that inserted inside the laptop PC. The display is polyethylene ("r =2:25) covered by the a perfect electrical conductor (PEC), the screen is the glass ("r =5:5; = 1012 S/m), and keyboard is polyethylene with a metallic box inside. The effect of the laptop PC housing with different angle () between the display and keyboard on the antenna pattern is also investigated. It is found that the effect of the different display-keyboard angle ( = 90, 120, and 135) on the antenna pattern is not significant. For the case of the antenna printed on a PCMCIA card inserted inside the laptop PC, more than 15 dB attenuation of the gain pattern (horizontal-polarization field) is found in the opposite direction of the PCMCIA slot on the laptop PC, and the average antenna gain is 8:0 dBi in the H-plane. It is suggested that the effect of the large ground plane of the PCMCIA card and the attenuation due to the laptop PC housing should be taken into considerations in designing the antennas for WLAN applications. Also, in addition to be used alone for a horizontally polarized antenna, the proposed antenna can also be used as a part of a diversity antenna.

| REFERENCES
[1] J. T. Bernhard, “Analysis of integrated antenna positions on a laptop
| computer for mobile data communication,” in Proc. IEEE AP-S. Int. Symp. Dig., Montreal, Canada, Jul. 1997, pp. 2210–2213.
[2] J. M. Johnson and Y. Rahmat-Sammi, “Wideband tab monopole an-
| tenna array for wireless adaptive and mobile information systems ap- plication,” in Proc IEEE AP-S Int. Symp. Dig., Jul. 1996, vol. 1, pp. 718–721.
[3] M. Ali, M. Okoniewski, M. A. Stuchly, and S. S. Stuchly, “Dual-fre-
| quency strip-sleeve monopole for laptop computers,” IEEE Trans. An- tennas Propag., vol. 47, no. 2, pp. 317–323, Feb. 1999.
[4] C. Soras, M. Karaboikis, G. Tsachtsiris, and V. Makios, “Analysis and
| design of an inverted-F antenna printed on a PCMCIA card for the 2.4 GHz ISM band,” IEEE Antennas Propag. Mag., vol. 44, no. 1, pp. 37–44, Feb. 2002.
[5] D. Chizhik, J. Ling, and R. A. Valenzuela, “The effect of electric field polarization on indoor propagation,” in Proc. IEEE Int. Conf. Universal Personal Communications, Oct. 1998, vol. 1, pp. 459–462.
[6] A. Alford and A. G. Kandoian, “Ultra-high frequency loop antenna,” Trans. AIEE, vol. 59, pp. 843–848, 1940.
[7] H.-R. Chuang, “Omni-directional horizontally polarized Alford loop strip antenna,” U.S. Patent 5,767,809, Jun. 16, 1998.
[8] H.-R. Chuang and L.-C. Kuo, “3-D FDTD design analysis of A 2.4 GHz polarization-diversity printed dipole-antenna with integrated balun and polarization-switching circuit for WLAN and wireless communication applications,” IEEE Trans. Microw. Theory Tech., vol. 51, no. 2, pp. 374–381, Feb. 2003.
[9] M. Ali and G. J. Hayes, “Analysis of integrated inverted-F antennas for bluetooth applications,” in Proc. IEEE Conf. Antennas and Propagation for Wireless Communication, Waltham, MA, Nov. 2000, pp. 21–24.
[10] M. Karaboikis, C. Soras, G. Tsachtsiris, and V. Makios, “Compact dual-printed inverted-F antenna diversity systems for portable wireless devices,” IEEE Antennas Wireless Propag. Lett., vol. 3, pp. 9–14, 2004.
[11] G. P. Karakoussis, A. I. Kostaridis, C. G. Biniaris, and D. I. Kaklamani, “A dual-band inverted-F antenna printed on a PC card for the ISM and UNNI bands,” Proc. IEEE WCNC2003, vol. 1, pp. 88–92, Mar. 2003.
[12] H. Matsuoka, I. Seto, T. Sekiguchi, H. Yoshida, A. Tsujimura, and M. Namekata, “Development of a PC card using planar antennas for wireless LAN on 2.4/5 GHz bands,” IEEE WCNC2005, vol. 1, pp. 573–577, Mar. 2005.

Aperture Antennas on Probe-Fed Hemispherical Metallic Cavities

K. W. Leung and H. Y. Lam

Abstract—Aperture antennas cut onto probe-fed hemispherical cavities are investigated theoretically and experimentally. The result is valid for any aperture position and width. The operating frequencies of the antennas are primarily controlled by the resonant modes of the hemispherical cavity, with the input impedances easily matched by changing the probe length and/or aperture size. When the probe length and aperture size are designed properly, a very wide bandwidth of 45% can be obtained. This bandwidth is nearly twice that of a bare monopole. The calculations are verified by measurements.

Index Terms—Coaxial probe, method of moments (MoM), resonant cavity, slot antenna.

I. INTRODUCTION

The slot antenna has been an important subject for many years, and both the open and cavity-backed slot antennas have been studied extensively, e.g., [1]–[4]. The slot antenna has a number of advantages including its conformability, lightweight, ease of fabrication, and high power capability. The slot antenna can be fabricated on a spherical body, such as a sphere-like satellite and the nose of a plane. In land mobile satellite systems, a spherical antenna array can overcome the scanning problems that are found in planar arrays at low elevation angles [5].
The slot antenna on a spherical body was studied extensively [6]–[11]. The simplest spherical antenna is the zonal slot located in the

Manuscript received July 5, 2005; revised May 23, 2006. This work was supported by a grant from the Research Grant Council of the Hong Kong Special Administrative Region, China (Project No.: CityU 1308/04E).
The authors is with the Department of Electronic Engineering, City University of Hong Kong, Kowloon, Hong Kong (e-mail: eekleung@cityu.edu.hk). Digital Object Identifier 10.1109/TAP.2006.884308
